Orbital-CubeSat-McGill/cdh-obc-hardware26-27/Ion-0/production/bom.csv

Designator | Footprint | Quantity | Value | LCSC Part #
BZ1 | Buzzer_CUI_CPT-9019S-SMT | 1 | Buzzer | C95163
C1, C10, C12, C13, C15, C18, C19, C20, C22, C25, C26, C7 | 0603 | 12 | 100nF | C16194197
C11 | 0402 | 1 | 47pF | C76970
C14, C16, C17 | 0603 | 3 | 22uF | C602037
C2, C3 | 0603 | 2 | 22pF | C408549
C21 | 0603 | 1 | 4.7nF | C1621
C23, C8 | 0603 | 2 | 1uF | C5199872
C27, C28 | 0603 | 2 | 0.22uF | C2167136
C29 | 0603 | 1 | 100uF | C48970603
C4, C5, C6 | 0603 | 3 | 0.1uF
C9 | 0603 | 1 | 100pF | C14665
D1 | SOT-23 | 1 | ESD3V3T2BHE3 | C1973960
D2, D3, D4, D5, D6 | 0603 | 5 | LED | C125093
D7, D8, D9 | 0603 | 3 | TVS_3V3 | C2693608
J1 | PinHeader_2x23_P2.54mm_Vertical | 1 | Beaglebone-green-P9 | C7501270
J10 | JST_SH_SM04B-SRSS-TB_1x04-1MP_P1.00mm_Horizontal | 1 | Conn_CAN | C160404
J13 | JST_SH_SM04B-SRSS-TB_1x04-1MP_P1.00mm_Horizontal | 1 | Conn_01x04 | C160404
J15 | TerminalBlock_Xinya_XY308-2.54-4P_1x04_P2.54mm_Horizontal | 1 | Conn_01x04
J2 | PinHeader_2x23_P2.54mm_Vertical | 1 | Beaglebone-green-P8 | C7501270
J3, J4, J5 | PinSocket_2x06_P2.54mm_Vertical_SMD | 3 | Conn_02x06_Odd_Even | C7501277
J6 | U.FL_Molex_MCRF_73412-0110_Vertical | 1 | Coaxial_Small | C88373
J7 | TerminalBlock_Xinya_XY308-2.54-4P_1x04_P2.54mm_Horizontal | 1 | Conn_Probs
J8 | TerminalBlock_Xinya_XY308-2.54-2P_1x02_P2.54mm_Horizontal | 1 | Conn_Heater
L1 | 0402 | 1 | 101nH | C86130
Q1, Q2 | SOT-23 | 2 | IRLML6244 | C5364311
R10, R24, R42, R47 | 0603 | 4 | 0 | C95177
R11, R14, R15, R16, R17, R22, R35, R36, R8 | 0603 | 9 | 10K | C98220
R18, R6, R7 | 0603 | 3 | 4.7K | C99782
R19 | 0603 | 1 | 5K | C862232
R20 | 0603 | 1 | 20K | C190611
R21 | 0603 | 1 | 33K | C4009252
R23, R28 | 0603 | 2 | 60 | C4110481
R25, R9 | 0603 | 2 | DNI
R26, R27 | 0603 | 2 | 33 | C108661
R29 | 0603 | 1 | 100 | C105588
R30 | 0603 | 1 | 470 | C666997
R31 | 0603 | 1 | 1k | C22548
R32, R33, R34, R37, R38, R45, R46 | 0603 | 7 | 330 | C105879
R39, R40 | 1206 | 2 | 0 | C22468037
R4, R41, R5 | 0603 | 3 | 100K | C14675
R43, R44 | 0603 | 2 | 0.05 | C346483
U1 | Texas_S-PWSON-N6-HDC2080 | 1 | HDC2080 | C918141
U2 | LGA-8_3x5mm_P1.25mm | 1 | MS5607-02BA | C97627
U3 | IC_BNO085 | 1 | BNO085
U4 | TCA9617A | 1 | TCA9617ADGKR | C400707
U5 | QFN-28_ALM | 1 | A4988SETTR-T | C54823939
U6 | XCVR_MAX-M10M-00B | 1 | MAX-M10M-00B | C4153167
U7 | TPS3850 | 1 | TPS3850H50DRCR | C2066856
U8 | SOIC-8_3.9x4.9mm_P1.27mm | 1 | SN65HVD230 | C12084
Y2 | 1206 | 1 | 9HT10-32.768KBZF-T | C32346
