Orbital-CubeSat-McGill/cdh-obc-hardware26-27/Ion-0/Ion-0.step

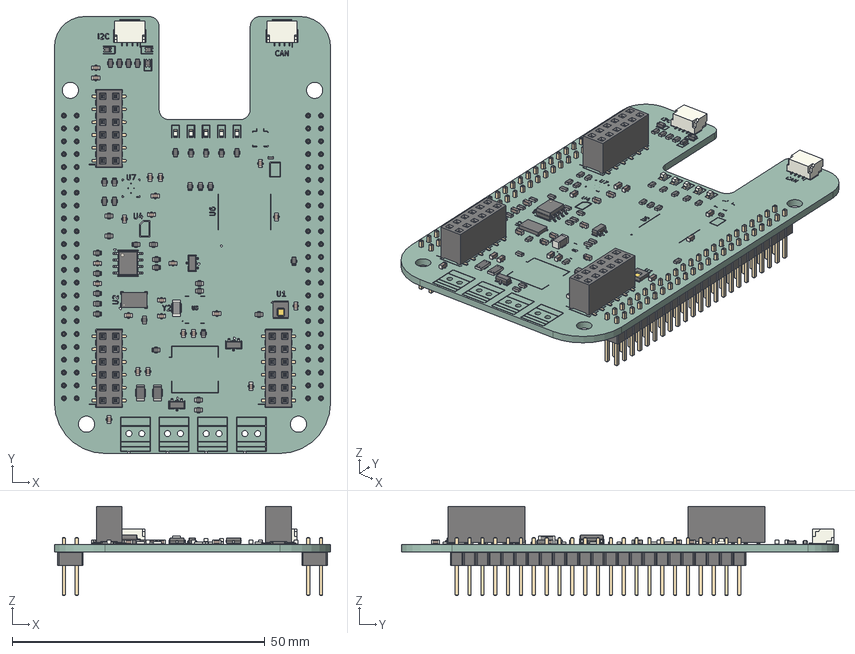
[picture p1: CAD file, 2026-07-23]
Ion-0/Ion-0.step
54.6 x 86.4 x 17.7 mm
C_0603_1608Metric x 23
R_0603_1608Metric x 36
L_1206_3216Metric
SOT-23 x 3
PinSocket_2x06_P2.54mm_Vertical_SMD x 3
JST_SH_SM04B-SRSS-TB_1x04-1MP_P1.00mm_Horizontal x 2
L_0402_1005Metric
D_0603 x 3
LED_0603_1608Metric x 5
SOIC-8_3.9x4.9mm_P1.27mm
LGA_8_3x5mm_P125mm
R_1206_3216Metric x 2
PinHeader_2x23_P254mm_Vertical x 2
Ion-0_silkscreen x 2
Ion-0_PCB
