Orbital-CubeSat-McGill/cdh-obc-hardware26-27/Ion-0/Ion-0.kicad_pcb

## KiCad design Ion-0/Ion-0.kicad_pcb (2026-07-23)

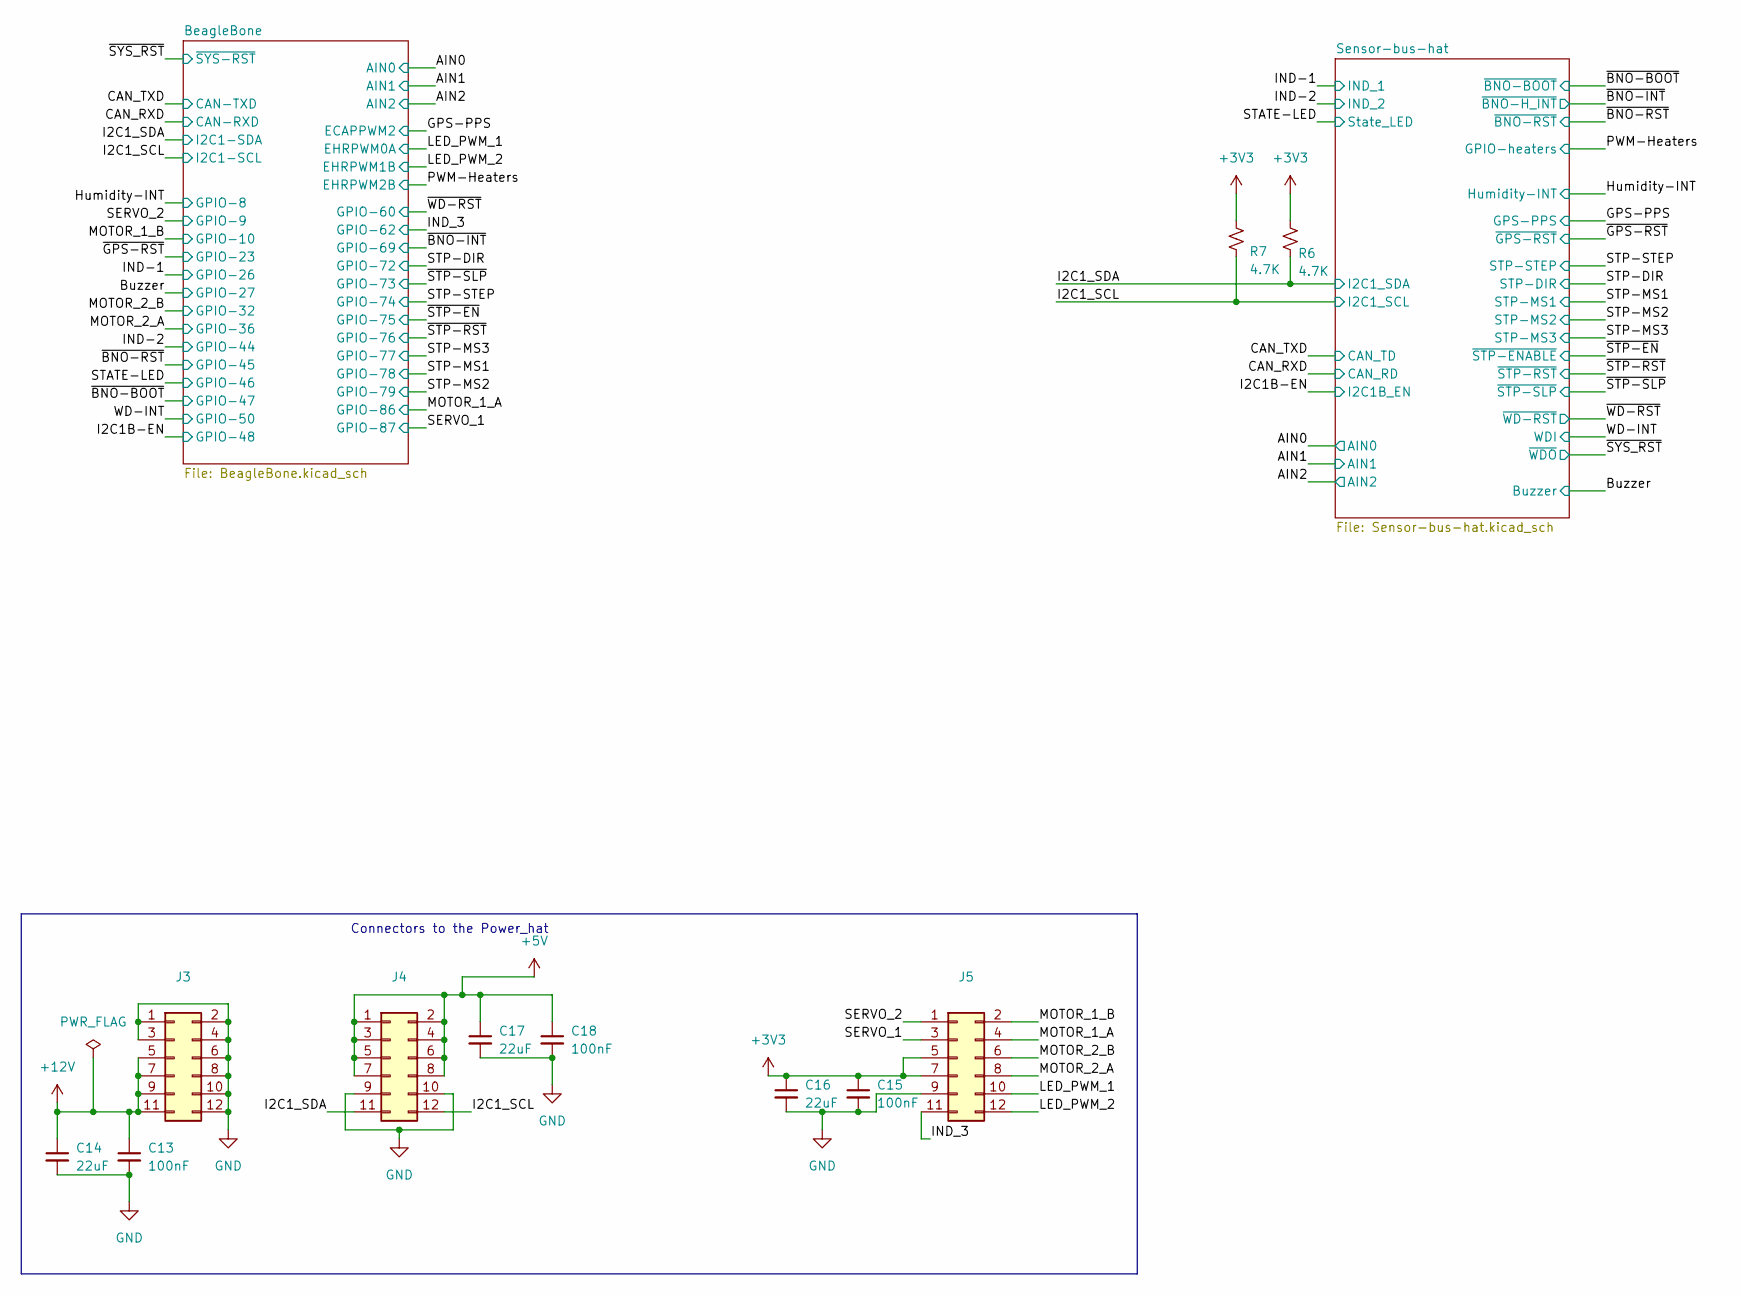
[picture p2: schematic Ion-0.kicad_sch, MI-CHAB-V0]

Parts:
C13, C15, C18: 100nF; C_0603_1608Metric
C14, C16, C17: 22uF; C_0603_1608Metric
J3, J4, J5: Conn_02x06_Odd_Even; PinSocket_2x06_P2.54mm_Vertical_SMD
R6, R7: 4.7K; R_0603_1608Metric_Pad0.98x0.95mm_HandSolder

Connections:
+3V3: C15.1, C16.1, J5.5, J5.7, R6.2, R7.1; also elsewhere on the board
+5V: C17.1, C18.1, J4.1, J4.2, J4.3, J4.4, J4.5, J4.6, J4.7, J4.8; also elsewhere on the board
+12V: C13.1, C14.1, J3.5, J3.7, J3.9, J3.11; also elsewhere on the board
/I2C1_SCL: J4.12, R7.2; also elsewhere on the board
/I2C1_SDA: J4.11, R6.1; also elsewhere on the board
/IND_3: J5.11; also elsewhere on the board
/LED_PWM_1: J5.10; also elsewhere on the board
/LED_PWM_2: J5.12; also elsewhere on the board
/MOTOR_1_A: J5.4; also elsewhere on the board
/MOTOR_1_B: J5.2; also elsewhere on the board
/MOTOR_2_A: J5.8; also elsewhere on the board
/MOTOR_2_B: J5.6; also elsewhere on the board
/SERVO_1: J5.3; also elsewhere on the board
/SERVO_2: J5.1; also elsewhere on the board
GND: C13.2, C14.2, C15.2, C16.2, C17.2, C18.2, J3.1, J3.2, J3.3, J3.4, J3.6, J3.8, J3.10, J3.12, J4.9, J4.10, J5.9; also elsewhere on the board

Notes on the sheet:
Connectors to the Power_hat

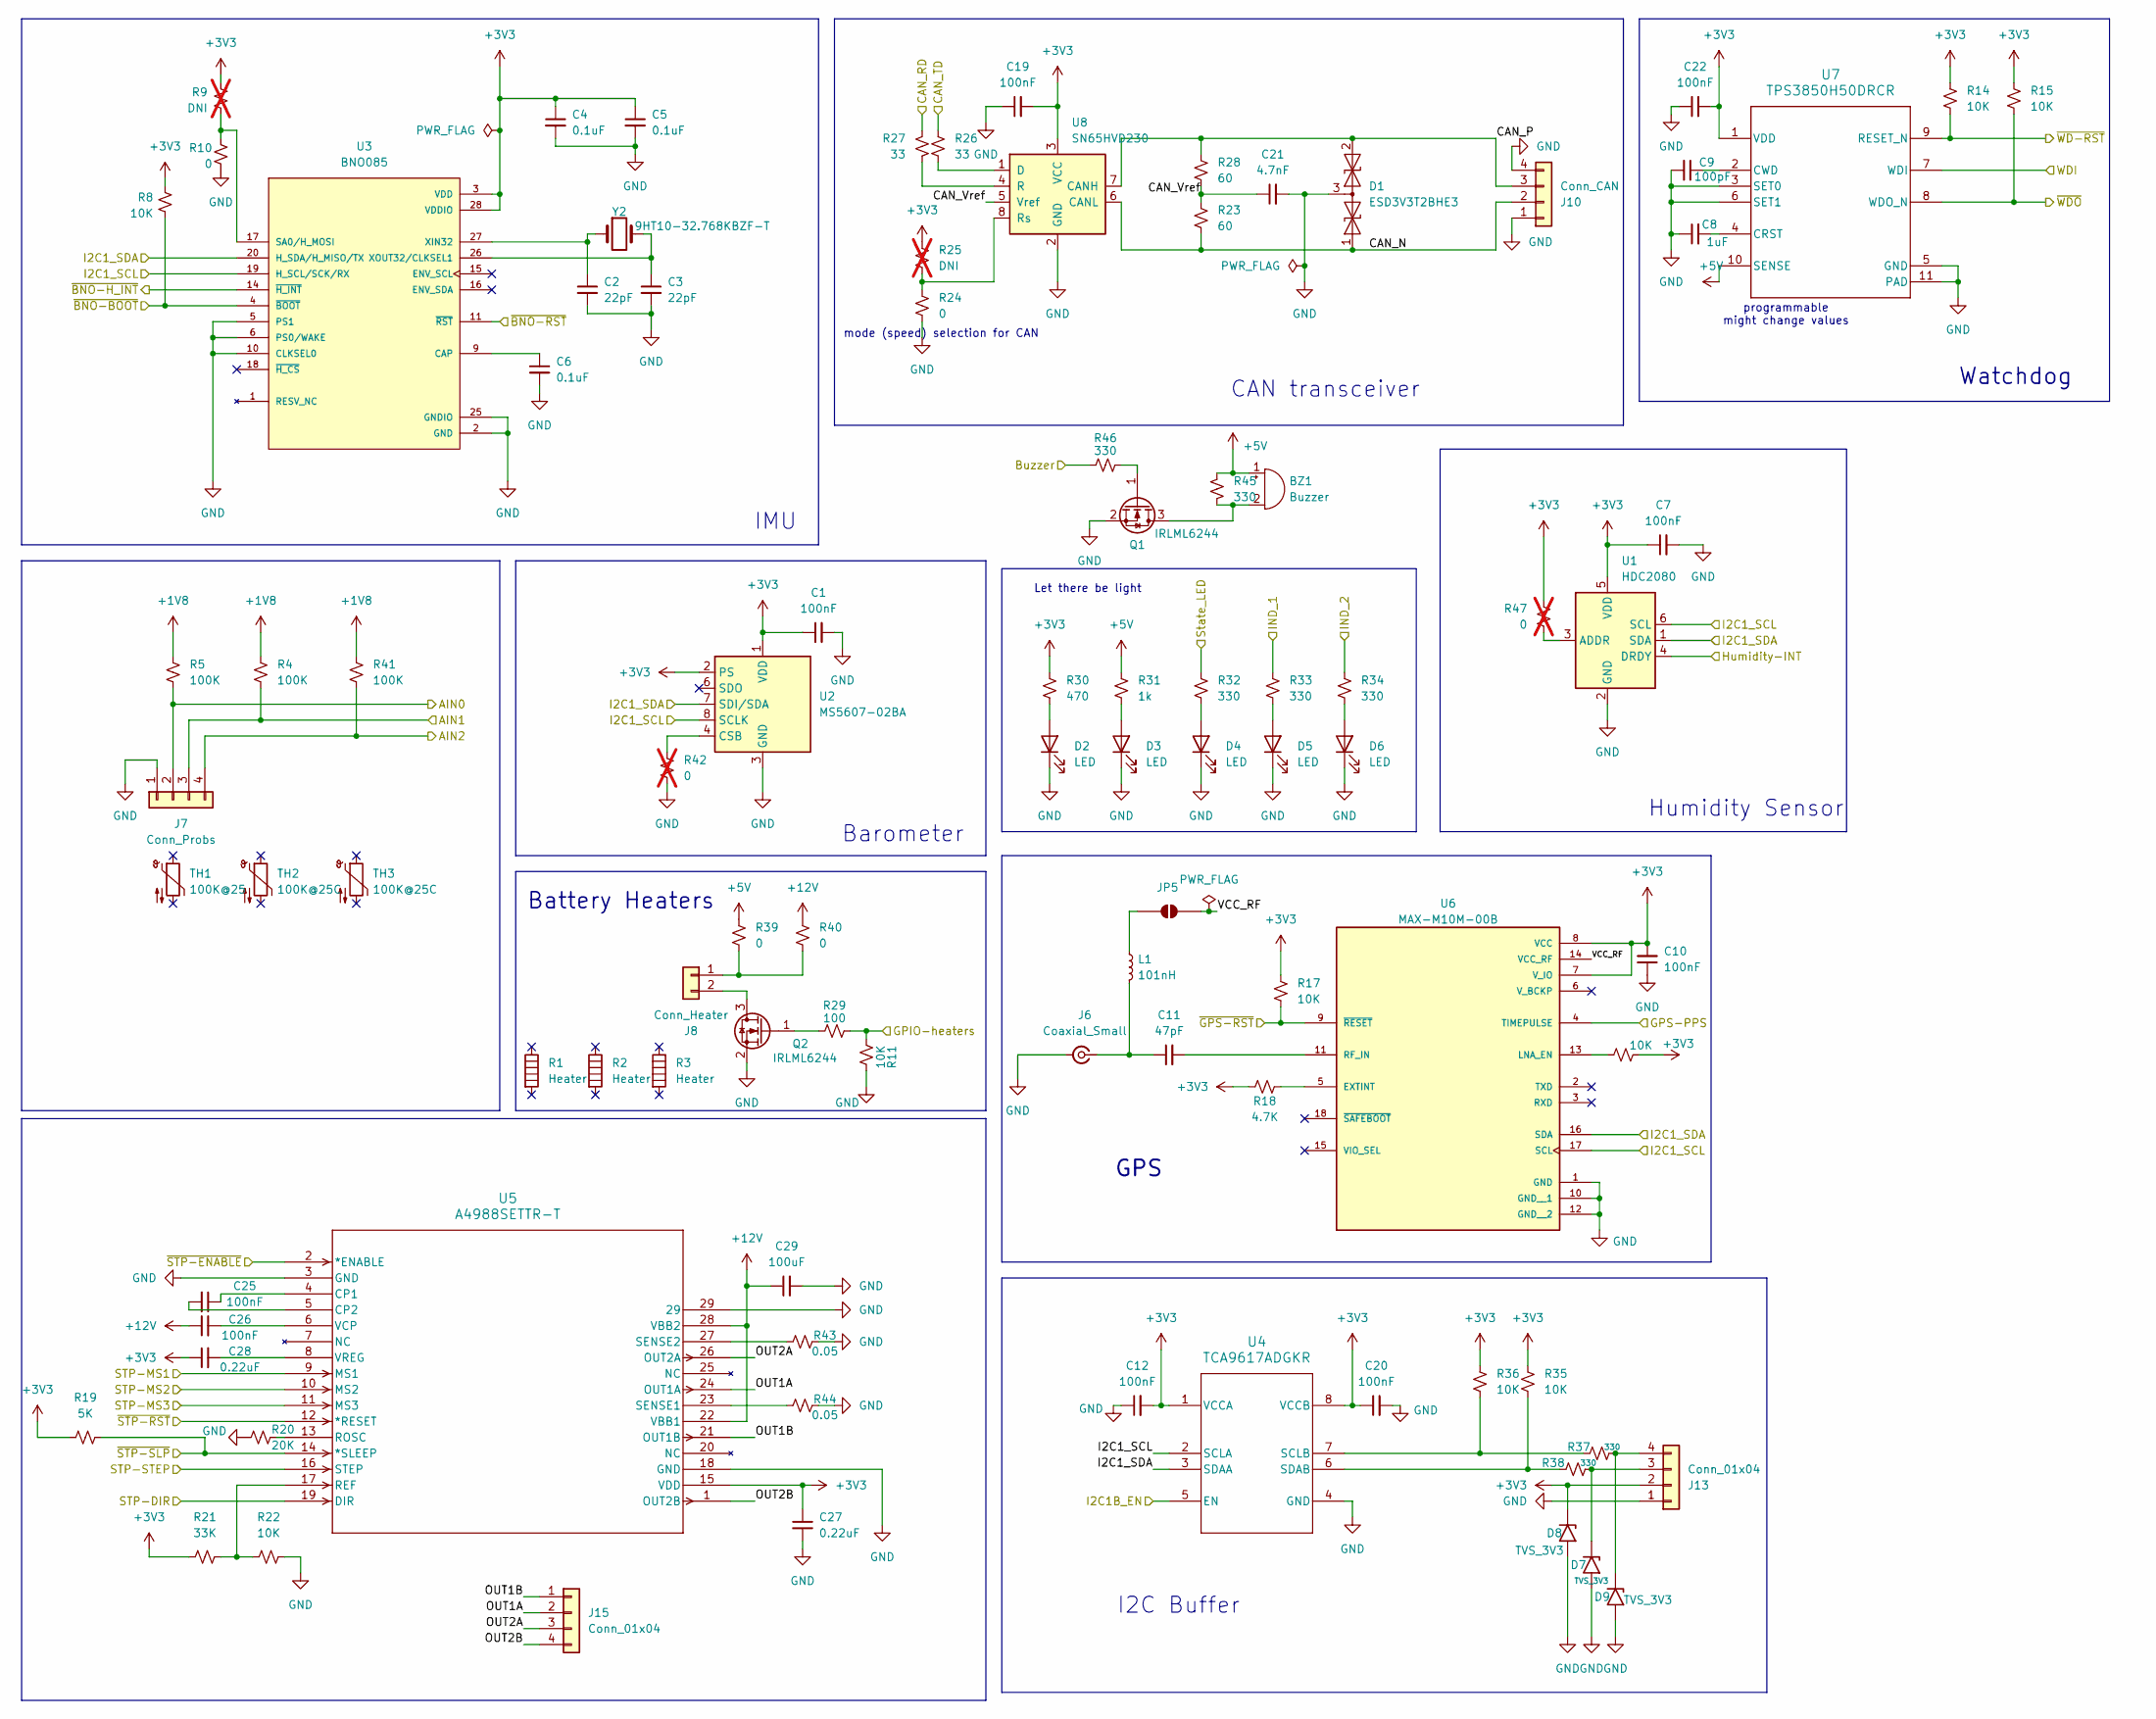
[picture p3: schematic Sensor-bus-hat.kicad_sch, Sensor-bus]

Parts:
BZ1: Buzzer; Buzzer_CUI_CPT-9019S-SMT
C1, C7, C10, C12, C19, C20, C22, C25, C26: 100nF; C_0603_1608Metric
C2, C3: 22pF; C_0603_1608Metric
C4, C5, C6: 0.1uF; C_0603_1608Metric
C8: 1uF; C_0603_1608Metric
C9: 100pF; C_0603_1608Metric
C11: 47pF; C_0402_1005Metric
C21: 4.7nF; C_0603_1608Metric
C27, C28: 0.22uF; C_0603_1608Metric
C29: 100uF; C_0603_1608Metric
D1: ESD3V3T2BHE3; SOT-23
D2, D3, D4, D5, D6: LED; LED_0603_1608Metric_Pad1.05x0.95mm_HandSolder
D7, D8, D9: TVS_3V3; D_0603_1608Metric
J6: Coaxial_Small; U.FL_Molex_MCRF_73412-0110_Vertical
J7: Conn_Probs; TerminalBlock_Xinya_XY308-2.54-4P_1x04_P2.54mm_Horizontal
J8: Conn_Heater; TerminalBlock_Xinya_XY308-2.54-2P_1x02_P2.54mm_Horizontal
J10: Conn_CAN; JST_SH_SM04B-SRSS-TB_1x04-1MP_P1.00mm_Horizontal
J13: Conn_01x04; JST_SH_SM04B-SRSS-TB_1x04-1MP_P1.00mm_Horizontal
J15: Conn_01x04; TerminalBlock_Xinya_XY308-2.54-4P_1x04_P2.54mm_Horizontal
JP5: SolderJumper_2_Open; SolderJumper-2_P1.3mm_Open_TrianglePad1.0x1.5mm
L1: 101nH; L_0402_1005Metric
Q1, Q2: IRLML6244; SOT-23
R1, R2, R3: Heater
R4, R5, R41: 100K; R_0603_1608Metric_Pad0.98x0.95mm_HandSolder
R8, R11, R14, R15, R16, R17, R22, R35, R36: 10K; R_0603_1608Metric_Pad0.98x0.95mm_HandSolder
R9, R25: DNI; R_0603_1608Metric_Pad0.98x0.95mm_HandSolder; not fitted
R10, R24: 0; R_0603_1608Metric_Pad0.98x0.95mm_HandSolder
R18: 4.7K; R_0603_1608Metric_Pad0.98x0.95mm_HandSolder
R19: 5K; R_0603_1608Metric_Pad0.98x0.95mm_HandSolder
R20: 20K; R_0603_1608Metric_Pad0.98x0.95mm_HandSolder
R21: 33K; R_0603_1608Metric_Pad0.98x0.95mm_HandSolder
R23, R28: 60; R_0603_1608Metric_Pad0.98x0.95mm_HandSolder
R26, R27: 33; R_0603_1608Metric_Pad0.98x0.95mm_HandSolder
R29: 100; R_0603_1608Metric_Pad0.98x0.95mm_HandSolder
R30: 470; R_0603_1608Metric_Pad0.98x0.95mm_HandSolder
R31: 1k; R_0603_1608Metric_Pad0.98x0.95mm_HandSolder
R32, R33, R34, R37, R38, R45, R46: 330; R_0603_1608Metric_Pad0.98x0.95mm_HandSolder
R39, R40: 0; R_1206_3216Metric
R42, R47: 0; R_0603_1608Metric_Pad0.98x0.95mm_HandSolder; not fitted
R43, R44: 0.05; R_0603_1608Metric_Pad0.98x0.95mm_HandSolder
TH1: 100K@25
TH2, TH3: 100K@25C
U1: HDC2080; Texas_S-PWSON-N6-HDC2080
U2: MS5607-02BA; LGA-8_3x5mm_P1.25mm
U3: BNO085; IC_BNO085; PARTREV v1.17
U4: TCA9617ADGKR; TCA9617A
U5: A4988SETTR-T; QFN-28_ALM
U6: MAX-M10M-00B; XCVR_MAX-M10M-00B; PARTREV C1
U7: TPS3850H50DRCR; TPS3850
U8: SN65HVD230; SOIC-8_3.9x4.9mm_P1.27mm
Y2: 9HT10-32.768KBZF-T; L_1206_3216Metric

Connections:
+1V8: R4.1, R5.1, R41.1; also elsewhere on the board
+3V3: C1.1, C4.1, C5.1, C7.1, C10.2, C12.2, C19.2, C20.1, C22.2, C27.1, C28.1, D8.1 (A1), J13.2, R8.1, R9.1, R14.1, R15.1, R16.2, R17.1, R18.2, R19.2, R21.1, R25.1, R30.1, R35.1, R36.1, R47.1, U1.5 (VDD), U2.1 (VDD), U2.2 (PS), U3.3 (VDD), U3.28 (VDDIO), U4.1 (VCCA), U4.8 (VCCB), U5.15 (VDD), U6.7 (V_IO), U6.8 (VCC), U7.1 (VDD), U8.3 (VCC); also elsewhere on the board
+5V: BZ1.1 (+), R31.1, R39.1, R45.1, U7.10 (SENSE); also elsewhere on the board
+12V: C26.1, C29.1, R40.1, U5.22 (VBB1), U5.28 (VBB2); also elsewhere on the board
/AIN0: J7.2, R5.2; also elsewhere on the board
/AIN1: J7.3, R4.2; also elsewhere on the board
/AIN2: J7.4, R41.2; also elsewhere on the board
/Buzzer: R46.1; also elsewhere on the board
/CAN_RXD: R27.1; also elsewhere on the board
/CAN_TXD: R26.1; also elsewhere on the board
/GPS-PPS: U6.4 (TIMEPULSE); also elsewhere on the board
/Humidity-INT: U1.4 (DRDY); also elsewhere on the board
/I2C1B-EN: U4.5 (EN); also elsewhere on the board
/I2C1_SCL: U1.6 (SCL), U2.8 (SCLK), U3.19 (H_SCL/SCK/RX), U4.2 (SCLA), U6.17 (SCL); also elsewhere on the board
/I2C1_SDA: U1.1 (SDA), U2.7 (SDI/SDA), U3.20 (H_SDA/H_MISO/TX), U4.3 (SDAA), U6.16 (SDA); also elsewhere on the board
/IND-1: R33.1; also elsewhere on the board
/IND-2: R34.1; also elsewhere on the board
/PWM-Heaters: R11.1, R29.1; also elsewhere on the board
/STATE-LED: R32.1; also elsewhere on the board
/STP-DIR: U5.19 (DIR); also elsewhere on the board
/STP-MS1: U5.9 (MS1); also elsewhere on the board
/STP-MS2: U5.10 (MS2); also elsewhere on the board
/STP-MS3: U5.11 (MS3); also elsewhere on the board
/STP-STEP: U5.16 (STEP); also elsewhere on the board
/Sensor-bus-hat/CAN_N: D1.1 (A1), J10.2, R23.2, U8.6 (CANL)
/Sensor-bus-hat/CAN_P: D1.2 (A2), J10.3, R28.1, U8.7 (CANH)
/Sensor-bus-hat/CAN_Vref: C21.1, R23.1, R28.2, U8.5 (Vref)
/Sensor-bus-hat/OUT1A: J15.2, U5.24 (OUT1A)
/Sensor-bus-hat/OUT1B: J15.1, U5.21 (OUT1B)
/Sensor-bus-hat/OUT2A: J15.3, U5.26 (OUT2A)
/Sensor-bus-hat/OUT2B: J15.4, U5.1 (OUT2B)
/Sensor-bus-hat/VCC_RF: JP5.2 (B), U6.14 (VCC_RF)
/WD-INT: U7.7 (WDI); also elsewhere on the board
/~BNO-BOOT: R8.2, U3.4 (~BOOT); also elsewhere on the board
/~BNO-INT: U3.14 (~H_INT); also elsewhere on the board
/~BNO-RST: U3.11 (~RST); also elsewhere on the board
/~GPS-RST: R17.2, U6.9 (~RESET); also elsewhere on the board
/~STP-EN: U5.2 (*ENABLE); also elsewhere on the board
/~STP-RST: U5.12 (*RESET); also elsewhere on the board
/~STP-SLP: R19.1, U5.14 (*SLEEP); also elsewhere on the board
/~SYS_RST: R15.2, U7.8 (WDO_N); also elsewhere on the board
/~WD-RST: R14.2, U7.9 (RESET_N); also elsewhere on the board
GND: C1.2, C2.2, C3.2, C4.2, C5.2, C6.2, C7.2, C8.1, C9.2, C10.1, C12.1, C19.1, C20.2, C21.2, C22.1, C27.2, C29.2, D1.3 (common), D2.1 (K), D3.1 (K), D4.1 (K), D5.1 (K), D6.1 (K), D7.2 (A2), D8.2 (A2), D9.2 (A2), J6.2 (Ext), J7.1, J10.1, J10.4, J13.1, Q1.2 (S), Q2.2 (S), R10.2, R11.2, R20.1, R22.2, R24.2, R42.2, R43.2, R44.2, U1.2 (GND), U2.3 (GND), U3.2 (GND), U3.5 (PS1), U3.6 (PS0/WAKE), U3.10 (CLKSEL0), U3.25 (GNDIO), U4.4 (GND), U5.3 (GND), U5.18 (GND), U5.29, U6.1 (GND), U6.10 (GND__1), U6.12 (GND__2), U7.3 (SET0), U7.5 (GND), U7.6 (SET1), U7.11 (PAD), U8.2 (GND); also elsewhere on the board
unnamed: BZ1.2 (-), Q1.3 (D), R45.2
unnamed: D2.2 (A), R30.2
unnamed: D3.2 (A), R31.2
unnamed: D4.2 (A), R32.2
unnamed: D5.2 (A), R33.2
unnamed: D6.2 (A), R34.2
unnamed: D7.1 (A1), J13.3, R38.2
unnamed: D9.1 (A1), J13.4, R37.2
unnamed: C11.1, J6.1 (In), L1.2
unnamed: J8.1, R39.2, R40.2
unnamed: J8.2, Q2.3 (D)
unnamed: JP5.1 (A), L1.1
unnamed: Q1.1 (G), R46.2
unnamed: Q2.1 (G), R29.2
unnamed: R42.1, U2.4 (CSB), U2.5 (CSB)
unnamed: R47.2, U1.3 (ADDR)
unnamed: C6.1, U3.9 (CAP)
unnamed: R9.2, R10.1, U3.17 (SA0/H_MOSI)
unnamed: C2.1, U3.27 (XIN32), Y2.1
unnamed: C3.1, U3.26 (XOUT32/CLKSEL1), Y2.2
unnamed: R36.2, R37.1, U4.7 (SCLB)
unnamed: R35.2, R38.1, U4.6 (SDAB)
unnamed: C25.1, U5.4 (CP1)
unnamed: C25.2, U5.5 (CP2)
unnamed: R21.2, R22.1, U5.17 (REF)
unnamed: R20.2, U5.13 (ROSC)
unnamed: R44.1, U5.23 (SENSE1)
unnamed: R43.1, U5.27 (SENSE2)
unnamed: C26.2, U5.6 (VCP)
unnamed: C28.2, U5.8 (VREG)
unnamed: R18.1, U6.5 (EXTINT)
unnamed: R16.1, U6.13 (LNA_EN)
unnamed: C11.2, U6.11 (RF_IN)
unnamed: C8.2, U7.4 (CRST)
unnamed: C9.1, U7.2 (CWD)
unnamed: R26.2, U8.1 (D)
unnamed: R27.2, U8.4 (R)
unnamed: R24.1, R25.2, U8.8 (Rs)

Notes on the sheet:
Barometer
Humidity Sensor
Watchdog
IMU
Let there be light
CAN transceiver
programmable might change values
GPS
I2C Buffer
mode (speed) selection for CAN
Battery Heaters

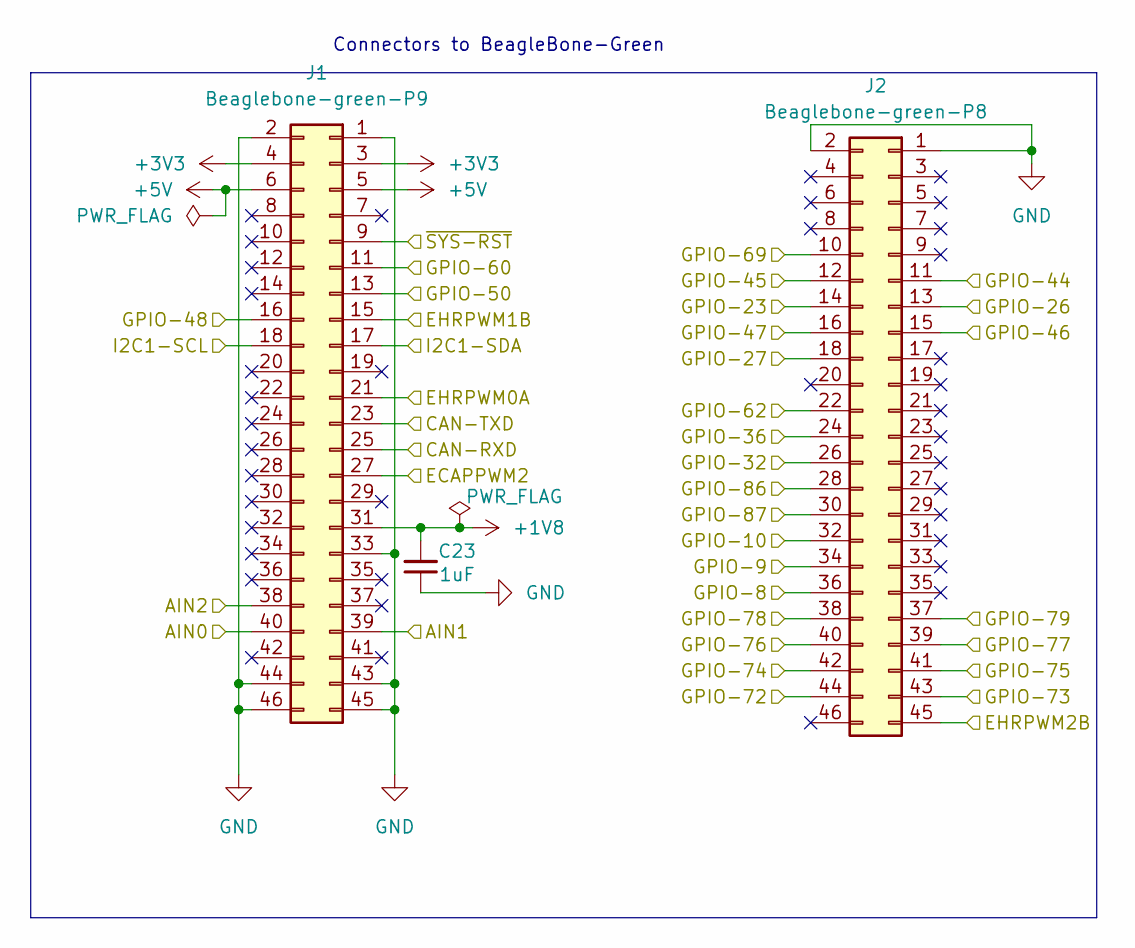
[picture p4: schematic BeagleBone.kicad_sch]

Parts:
C23: 1uF; C_0603_1608Metric
J1: Beaglebone-green-P9; PinHeader_2x23_P2.54mm_Vertical
J2: Beaglebone-green-P8; PinHeader_2x23_P2.54mm_Vertical

Connections:
+1V8: C23.2, J1.31; also elsewhere on the board
+3V3: J1.3, J1.4; also elsewhere on the board
+5V: J1.5, J1.6; also elsewhere on the board
/AIN0: J1.40; also elsewhere on the board
/AIN1: J1.39; also elsewhere on the board
/AIN2: J1.38; also elsewhere on the board
/Buzzer: J2.18; also elsewhere on the board
/CAN_RXD: J1.25; also elsewhere on the board
/CAN_TXD: J1.23; also elsewhere on the board
/GPS-PPS: J1.27; also elsewhere on the board
/Humidity-INT: J2.36; also elsewhere on the board
/I2C1B-EN: J1.16; also elsewhere on the board
/I2C1_SCL: J1.18; also elsewhere on the board
/I2C1_SDA: J1.17; also elsewhere on the board
/IND-1: J2.13; also elsewhere on the board
/IND-2: J2.11; also elsewhere on the board
/IND_3: J2.22; also elsewhere on the board
/LED_PWM_1: J1.21; also elsewhere on the board
/LED_PWM_2: J1.15; also elsewhere on the board
/MOTOR_1_A: J2.28; also elsewhere on the board
/MOTOR_1_B: J2.32; also elsewhere on the board
/MOTOR_2_A: J2.24; also elsewhere on the board
/MOTOR_2_B: J2.26; also elsewhere on the board
/PWM-Heaters: J2.45; also elsewhere on the board
/SERVO_1: J2.30; also elsewhere on the board
/SERVO_2: J2.34; also elsewhere on the board
/STATE-LED: J2.15; also elsewhere on the board
/STP-DIR: J2.44; also elsewhere on the board
/STP-MS1: J2.38; also elsewhere on the board
/STP-MS2: J2.37; also elsewhere on the board
/STP-MS3: J2.39; also elsewhere on the board
/STP-STEP: J2.42; also elsewhere on the board
/WD-INT: J1.13; also elsewhere on the board
/~BNO-BOOT: J2.16; also elsewhere on the board
/~BNO-INT: J2.10; also elsewhere on the board
/~BNO-RST: J2.12; also elsewhere on the board
/~GPS-RST: J2.14; also elsewhere on the board
/~STP-EN: J2.41; also elsewhere on the board
/~STP-RST: J2.40; also elsewhere on the board
/~STP-SLP: J2.43; also elsewhere on the board
/~SYS_RST: J1.9; also elsewhere on the board
/~WD-RST: J1.11; also elsewhere on the board
GND: C23.1, J1.1, J1.2, J1.33, J1.43, J1.44, J1.45, J1.46, J2.1, J2.2; also elsewhere on the board

Notes on the sheet:
Connectors to BeagleBone-Green

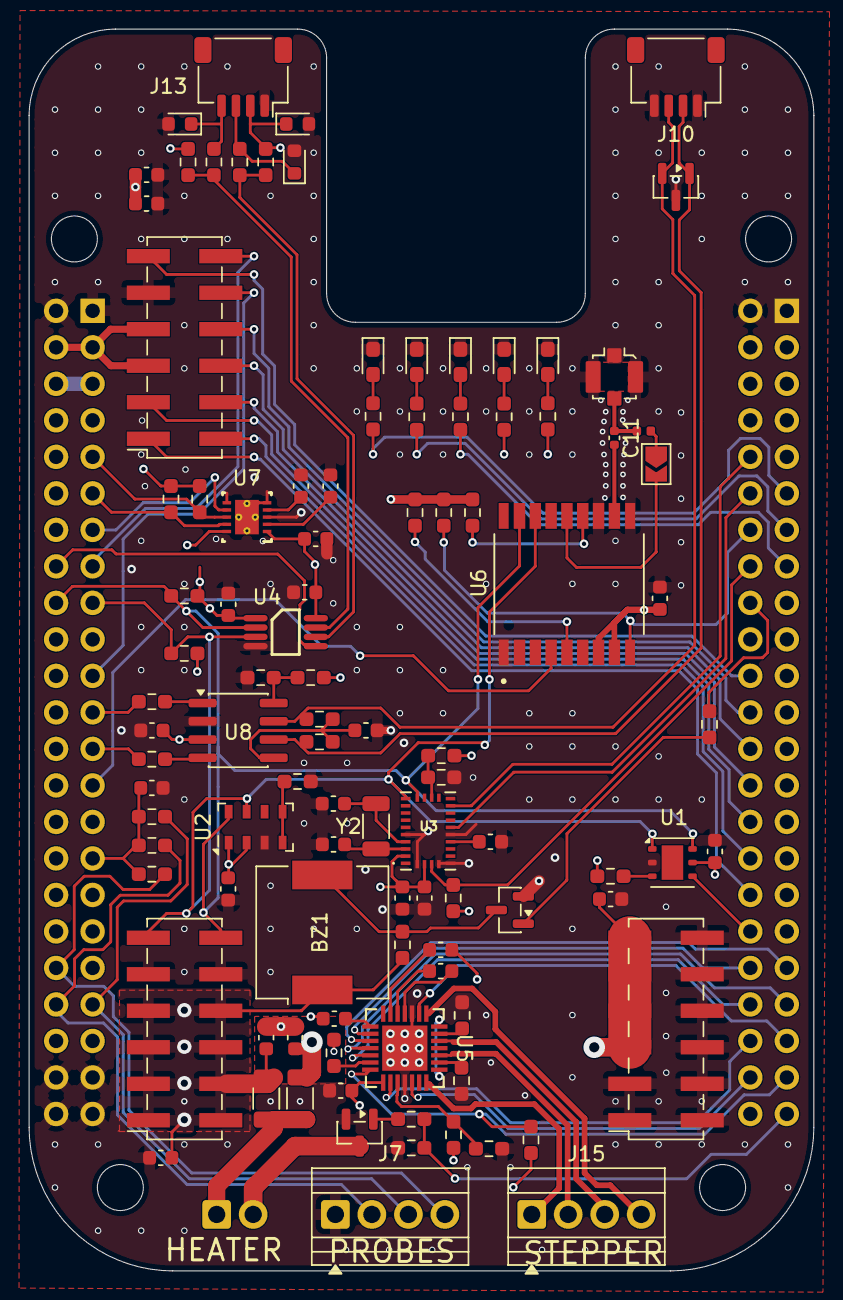
[picture p5: board Ion-0.kicad_pcb from above]

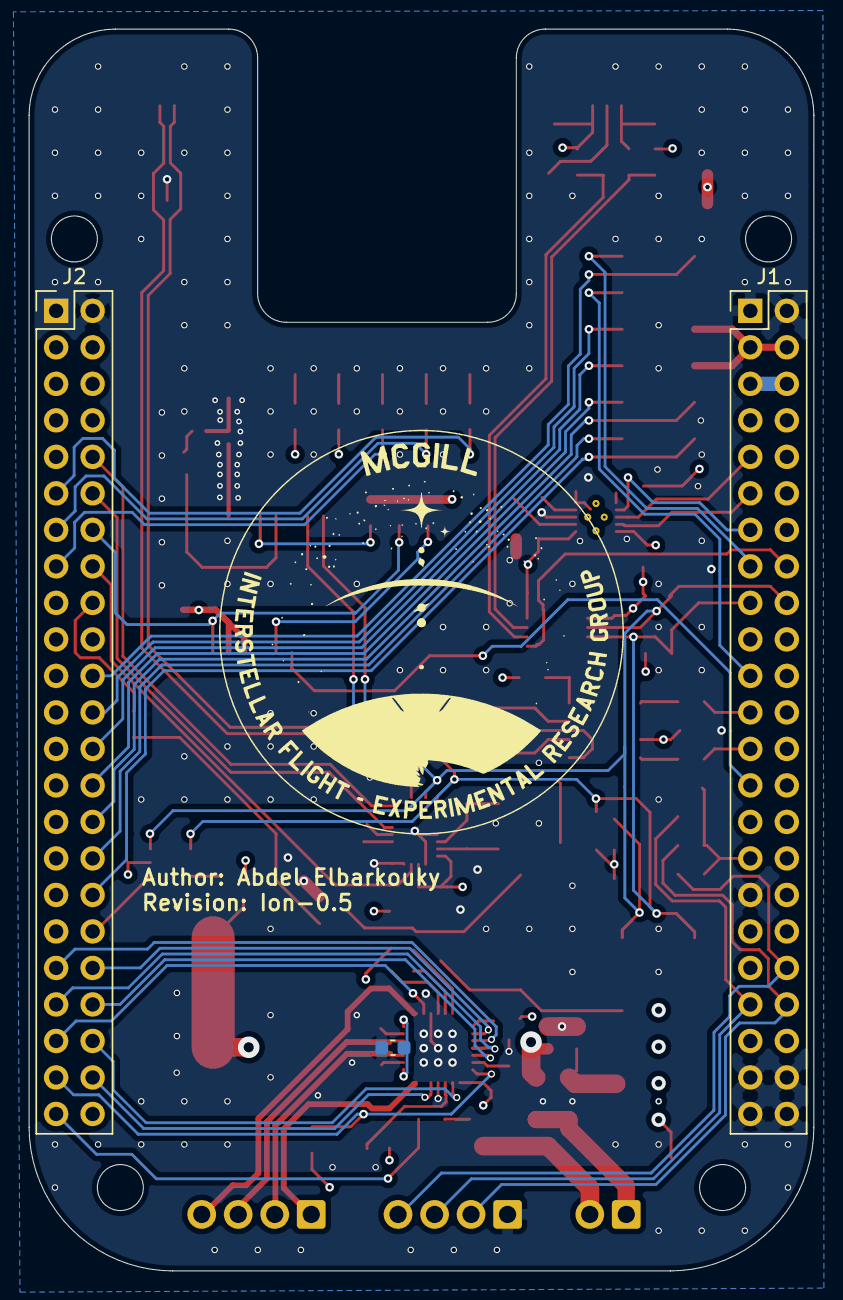
[picture p6: board Ion-0.kicad_pcb from below]

Board: 4 copper layers, 54.6 x 86.4 mm, 104 parts (3 on the bottom side), 90 nets.
