Orbital-CubeSat-McGill/cdh-obc-hardware26-27/Ion-1/Ion-1/communication.kicad_sch

## KiCad design Ion-1/Ion-1/communication.kicad_sch (2026-08-25)

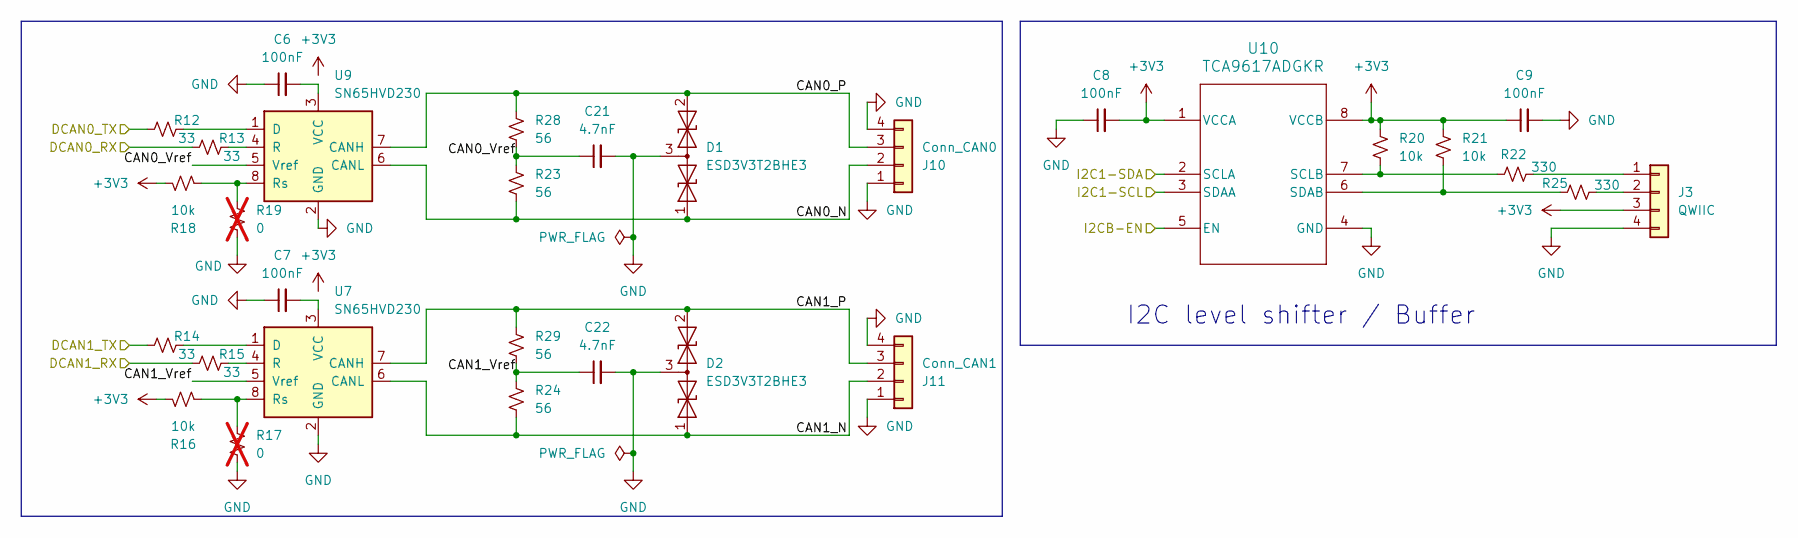
[picture p7: schematic communication.kicad_sch]

Parts:
C6, C7, C8, C9: 100nF
C21, C22: 4.7nF; C_0603_1608Metric
D1, D2: ESD3V3T2BHE3; SOT-23
J3: QWIIC
J10: Conn_CAN0; JST_SH_SM04B-SRSS-TB_1x04-1MP_P1.00mm_Horizontal
J11: Conn_CAN1; JST_SH_SM04B-SRSS-TB_1x04-1MP_P1.00mm_Horizontal
R12, R13, R14, R15: 33
R16, R18, R20, R21: 10k
R17, R19: 0; not fitted
R22, R25: 330
R23, R24, R28, R29: 56; R_0603_1608Metric_Pad0.98x0.95mm_HandSolder
U7, U9: SN65HVD230; SOIC-8_3.9x4.9mm_P1.27mm
U10: TCA9617ADGKR; DGK0008A

Connections:
+3V3: C8.2, C9.1, J3.3, R16.1, R18.1, R20.1, R21.1, U10.1 (VCCA), U10.8 (VCCB)
CAN0_N: D1.1 (A1), J10.2, R23.2, U9.6 (CANL)
CAN0_P: D1.2 (A2), J10.3, R28.1, U9.7 (CANH)
CAN0_Vref: C21.1, R23.1, R28.2, U9.5 (Vref)
CAN1_N: D2.1 (A1), J11.2, R24.2, U7.6 (CANL)
CAN1_P: D2.2 (A2), J11.3, R29.1, U7.7 (CANH)
CAN1_Vref: C22.1, R24.1, R29.2, U7.5 (Vref)
DCAN0_RX: R13.1
DCAN0_TX: R12.1
DCAN1_RX: R15.1
DCAN1_TX: R14.1
GND: C6.1, C7.1, C8.1, C9.2, C21.2, C22.2, D1.3 (common), D2.3 (common), J3.4, J10.1, J10.4, J11.1, J11.4, R17.2, R19.2, U7.2 (GND), U9.2 (GND), U10.4 (GND)
I2C1-SCL: U10.3 (SDAA)
I2C1-SDA: U10.2 (SCLA)
I2CB-EN: U10.5 (EN)
unnamed: C6.2, U9.3 (VCC)
unnamed: C7.2, U7.3 (VCC)
unnamed: J3.1, R22.2
unnamed: J3.2, R25.2
unnamed: R12.2, U9.1 (D)
unnamed: R13.2, U9.4 (R)
unnamed: R14.2, U7.1 (D)
unnamed: R15.2, U7.4 (R)
unnamed: R16.2, R17.1, U7.8 (Rs)
unnamed: R18.2, R19.1, U9.8 (Rs)
unnamed: R20.2, R22.1, U10.7 (SCLB)
unnamed: R21.2, R25.1, U10.6 (SDAB)

Notes on the sheet:
I2C level shifter / Buffer
