Orbital-CubeSat-McGill/cdh-obc-hardware26-27/Ion-1/Ion-1/sensorsandsuch.kicad_sch

## KiCad design Ion-1/Ion-1/sensorsandsuch.kicad_sch (2026-08-25)

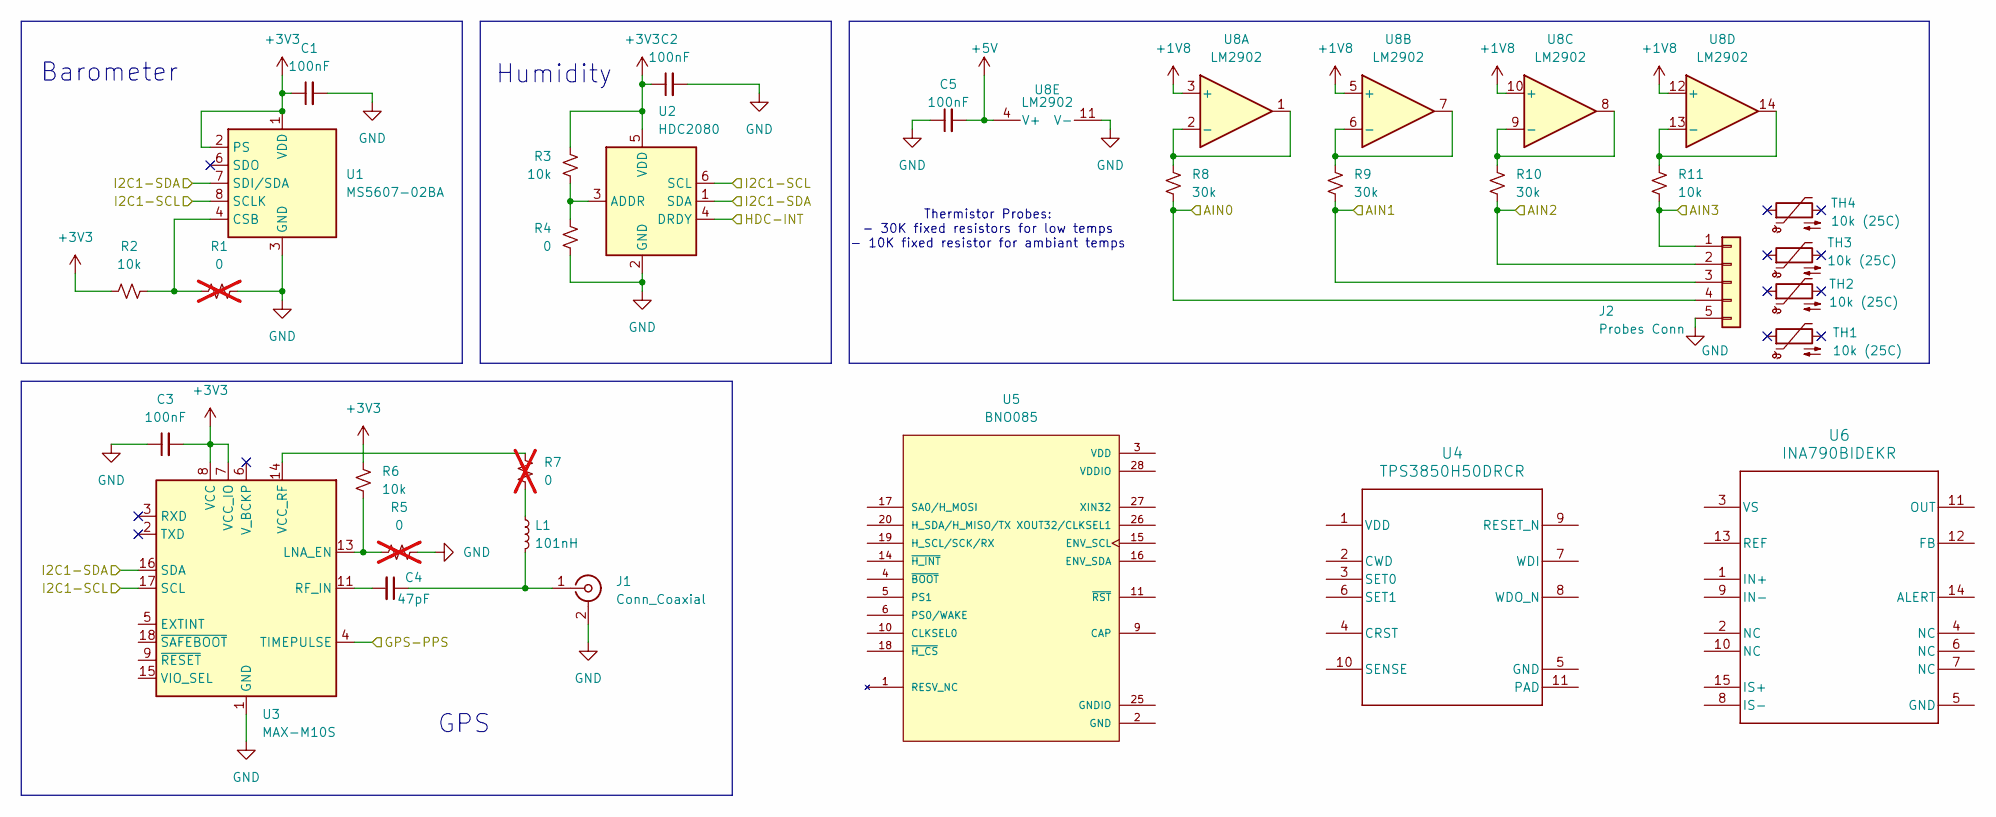
[picture p8: schematic sensorsandsuch.kicad_sch]

Parts:
C1, C2, C3, C5: 100nF
C4: 47pF; C_0402_1005Metric
J1: Conn_Coaxial
J2: Probes Conn
L1: 101nH
R1, R5, R7: 0; not fitted
R2, R3, R6, R11: 10k
R4: 0
R8, R9, R10: 30k
TH1, TH2, TH3, TH4: 10k (25C)
U1: MS5607-02BA; LGA-8_3x5mm_P1.25mm
U2: HDC2080; Texas_S-PWSON-N6-HDC2080
U3: MAX-M10S; ublox_MAX
U4: TPS3850H50DRCR; DRC0010J
U5: BNO085; IC_BNO085; PARTREV v1.17
U6: INA790BIDEKR; DEK0015A-MFG
U8: LM2902

Connections:
+1V8: U8.3 (+), U8.5 (+), U8.10 (+), U8.12 (+)
+3V3: C1.1, C2.1, C3.2, R2.1, R3.1, R6.1, U1.1 (VDD), U1.2 (PS), U2.5 (VDD), U3.7 (VCC_IO), U3.8 (VCC)
+5V: C5.2, U8.4 (V+)
AIN0: J2.4, R8.2
AIN1: J2.3, R9.2
AIN2: J2.2, R10.2
AIN3: J2.1, R11.2
GND: C1.2, C2.2, C3.1, C5.1, J1.2 (Ext), J2.5, R1.2, R4.2, R5.2, U1.3 (GND), U2.2 (GND), U3.1 (GND), U3.10 (GND), U3.12 (GND), U8.11 (V-)
GPS-PPS: U3.4 (TIMEPULSE)
HDC-INT: U2.4 (DRDY)
I2C1-SCL: U1.8 (SCLK), U2.6 (SCL), U3.17 (SCL)
I2C1-SDA: U1.7 (SDI/SDA), U2.1 (SDA), U3.16 (SDA)
unnamed: C4.1, J1.1 (In), L1.2
unnamed: C4.2, U3.11 (RF_IN)
unnamed: L1.1, R7.2
unnamed: R1.1, R2.2, U1.4 (CSB), U1.5 (CSB)
unnamed: R3.2, R4.1, U2.3 (ADDR)
unnamed: R5.1, R6.2, U3.13 (LNA_EN)
unnamed: R7.1, U3.14 (VCC_RF)
unnamed: R8.1, U8.1, U8.2 (-)
unnamed: R9.1, U8.6 (-), U8.7
unnamed: R10.1, U8.8, U8.9 (-)
unnamed: R11.1, U8.13 (-), U8.14
unnamed: U5.1 (RESV_NC), U5.7 (RESV_NC), U5.8 (RESV_NC), U5.12 (RESV_NC), U5.13 (RESV_NC), U5.21 (RESV_NC), U5.22 (RESV_NC), U5.23 (RESV_NC), U5.24 (RESV_NC)

Notes on the sheet:
Humidity
GPS
Thermistor Probes: - 30K fixed resistors for low temps - 10K fixed resistor for ambiant temps
Barometer
